Jose-Ramonda/PROYECTOFINAL_MASTER/Informe/main.tex

%\documentclass[12pt,a4paper]{article}
\documentclass[12pt,a4paper,twoside]{article}

% =======================
% Paquetes básicos
% =======================
\usepackage[spanish]{babel}    % Idioma español
\usepackage[utf8]{inputenc}    % Acentos en UTF-8
\usepackage[T1]{fontenc}       % Codificación de salida
\usepackage{lmodern}           % Fuente mejorada (Latin Modern)
\usepackage{graphicx}          % Insertar imágenes
\usepackage{amsmath, amssymb}  % Matemáticas
\usepackage{geometry}          % Márgenes
\usepackage{hyperref}          % Hipervínculos
\usepackage{enumitem}          % Listas personalizadas
\usepackage{caption}           % Mejoras en títulos de figuras/tablas
\usepackage{setspace}
\usepackage{float}   % Para usar [H] en tablas y figuras
\usepackage{csvsimple} %Para tablas
\usepackage{booktabs} % para tablas más limpias
\usepackage{graphicx}
\usepackage[style=american]{csquotes}

\usepackage{listings}
\usepackage{xcolor} % Para darle colores al código
\usepackage{bytefield}
\usepackage{graphicx} % Para rotar el texto si es necesario

\usepackage[nopatch=footnote]{microtype}%Corrige supuestamente los Overfull

%Veamos esto
\usepackage{tikz}
\usepackage{pgf-umlsd}

\lstset{
	language=C,
	basicstyle=\ttfamily\small,
	keywordstyle=\color{blue},
	commentstyle=\color{green!60!black},
	stringstyle=\color{orange},
	numbers=left,
	numberstyle=\tiny\color{gray},
	breaklines=true,
	frame=single,
}
% Configuración de márgenes
%\geometry{top=2.5cm, bottom=2.5cm, left=3cm, right=3cm}
\geometry{top=2.5cm, bottom=2.5cm, inner=3.5cm, outer=2.5cm}
% Para que LaTeX busque imágenes siempre en la carpeta img/
\graphicspath{{img/}}

% =======================
% Documento
% =======================
\begin{document}
	
	% Carátula
	\input{tex/00Caratula.tex}
	\clearpage
	\input{tex/01seccion1.tex}
	\thispagestyle{empty}%Oculta el indice
	\tableofcontents 
	\newpage

	% Secciones

	\input{tex/02seccion2.tex}
	\input{tex/03seccion3.tex}
	\input{tex/04seccion4.tex}
	\input{tex/05seccion5.tex}
	\input{tex/06seccion6.tex}
	\input{tex/07seccion7.tex}

\end{document}
