Jose-Ramonda/PROYECTOFINAL_MASTER/Informe/tex/00Caratula.tex

\begin{titlepage}
	\begin{center}
		\doublespacing
		\Large
		Universidad Nacional de Rosario \\
		Facultad de Ciencias Exactas, Ingeniería y Agrimensura
		
		\vspace{1cm}
		
		\textbf{\huge Proyecto Final de Carrera: \newline Trabajo final} \\[0.5cm]
		\textbf{\LARGE Control de Acceso para institución educativa} \\[0.5cm]
		\textbf{Año: 2026}
		
		\vfill
		
		% ===================
		% Datos del autor
		% ===================
		\large
		\textbf{Autor:} Ramonda, José \\
		\textbf{Legajo:} R-4423/7
		
		\vspace{1.5cm}
		
		% ===================
		% Director
		% ===================
		\large
		\textbf{Director:} \\

		 Prof. Ing. Daniel Marquez 

		\vfill
		
		\large
		Rosario, \today
		
	\end{center}
\end{titlepage}
