Jose-Ramonda/PROYECTOFINAL_MASTER/Informe/tex/06seccion6.tex

\section{Servidor}
El servidor constituye el núcleo del sistema. Consiste en una computadora con una distribución de Linux como sistema operativo, conectada por un lado al bus RS-485 mediante una interfaz serie y, por otro, tanto a la red de área local de la institución como a Internet.

La elección de Linux como entorno de ejecución otorga portabilidad al sistema, permitiendo su despliegue sobre diversas plataformas de hardware según la disponibilidad y los requerimientos de la instalación. Durante la etapa de desarrollo y pruebas, se utilizó una computadora portátil con Ubuntu junto a un convertidor USB a RS-485 estándar. Para la puesta en producción en campo, el cambio fundamental a nivel de hardware consiste en la incorporación de un convertidor de grado industrial con aislamiento galvánico (optoacoplado y con protecciones ante transitorios), lo cual previene bucles de masa (\textit{ground loops}) y garantiza la seguridad eléctrica tanto del equipo anfitrión como del bus de comunicaciones.

Cumplido este recaudo, el software puede desplegarse en cualquier servidor o PC convencional que ejecute Linux. Asimismo, una alternativa viable y compacta es el empleo de una computadora de placa reducida (\textit{Single Board Computer} o SBC), como una Raspberry Pi. Esta opción resulta especialmente conveniente cuando no se dispone de infraestructura de servidores previa o cuando se requiere ubicar la unidad de control en proximidad física al tendido del bus. Entre las ventajas añadidas del uso de una SBC destacan su bajo consumo energético y la posibilidad de prescindir de convertidores USB intermedios mediante el conexionado de un transceptor RS-485 directamente a los pines UART/GPIO del procesador.

La arquitectura consta de cuatro procesos

\begin{itemize}
    \item Un gestor de la interfaz serial que se encarga del polling y los comandos hacia los esclavos.
    \item La interfaz de usuario.
    \item El servidor HTTP.
    \item Un broker MQTT para comunicar los procesos entre sí.
\end{itemize}

La interfaz serial no solo gestiona la comunicación con los terminales, sino que también se ocupa del monitoreo de la conetividad de estos por ambas vías y resuelve internamente todo lo relacionado con los accesos mediante tags NFC.

El servidor HTTP se implementa sobre una instancia de node-red y también incorpora algunas funcionalidades auxiliares.

La interfaz de usuario está programada en python y utiliza la API de la aplicación de mensajería \enquote{Telegram}.

\subsection{Programa principal}
El dominio de la interfaz serial se ocupa de realizar las encuestas periódicas, verificar la conetividad y comandar a los esclavos, así como de procesar los datos recibidos por estos.

Está programado en python y se compone de varios módulos. Cada módulo incluye funciones que pueden ser llamadas desde otros archivos así como procesos que se disparan en hilos paralelos de ejecución (librería \textit{threading.py}). El programa principal \textit{main.py} crea los procesos y dispara los hilos.

En principio esta arquitectura presenta similitudes con la de los terminales implementados en FreeRTOS, pero existen diferencias clave que hay mencionar, la primera es que si bien los hilos se ejecutan mediante una estructura apropiativa gestionada por un scheduler que vive en el kernel del sistema operativo no existe en este caso tal cosa como asignación de prioridades, todos los hilos en estado ready comparten time slices del mismo tamaño.

Otro punto clave es el GIL de python o \enquote{Global Interpreter Lock}, Un semáforo de exclusión mutua (\textit{mutex}) diseñado para proteger las estructuras de memoria internas y el mecanismo de conteo de referencias frente a condiciones de carrera. Por esto, solo un hilo ejecuta código Python a la vez por proceso, impidiendo el paralelismo real en tareas de cálculo intensivo. Sin embargo, para operaciones de entrada/salida (como la comunicación serie o de red), el GIL se libera durante las esperas, permitiendo una concurrencia fluida y eficiente entre módulos.

A continuación se describen los distintos módulos que componen el sistema

\subsubsection{Módulo serie.py}
Este módulo es la interfaz serial del servidor e implementa la ejecución de un maestro del protocolo \enquote{Ramodbus}. El hilo principal de ejecución no requiere de una máquina de estados, sino que es secuencial. Intercambia información con los otros módulos mediante una cola de entrada y sendas colas de salida para cada nodo.

Las direcciones o identificadores de los nodos activos se definen en una tupla dentro del archivo de configuración. El hilo de comunicaciones itera cíclicamente sobre estos identificadores ejecutando la siguiente secuencia por cada nodo:

\begin{enumerate}
    \item Revisa el estado del nodo, si está marcado como desconectado, se omite su consulta para no penalizar el tiempo de ciclo.
    \item Comprueba si existen comandos pendientes en la cola asociada a dicho nodo.
    \item Si la cola contiene elementos, extrae el comando y lo transmite; en caso contrario, envía una trama periódica de consulta (\textit{polling}).
    \item Espera la respuesta del esclavo, luego de que responda o de un timeout pasa al siguiente nodo y repite.
\end{enumerate}

Si un nodo no responde, se incrementa un contador de fallos consecutivos que se reinicia ante cualquier recepción válida. Al superarse un umbral predefinido de reintentos fallidos, el nodo pasa al estado \textit{desconectado} y se emite una notificación al resto del sistema

Cuando se recibe una respuesta válida, si se trata de una simple confirmación (\texttt{ACK}) se descarta. Si en cambio contiene datos útiles, se encapsula en un diccionario con el formato \texttt{\{
                        \enquote{id\_nodo}: id\_nodo,
                        \enquote{cmd}: cmd\_recibido,
                        \enquote{payload}: payload\_recibido
                    \}}

La construcción de tramas se centraliza en una función encargada de estructurar el encabezado y computar el código de redundancia cíclica (CRC). Por su parte, la rutina de recepción bloqueante valida la dirección del destinatario, el encabezado y la coherencia del CRC, retornando la carga útil decodificada o el código de error correspondiente.

En el archivo de configuración se definen tres parámetros que afectan a la velociad de la comunicación.
\begin{itemize}
\item \textbf{Velocidad de transmisión (\textit{Baud rate}):} Tasa de transferencia en baudios del enlace físico.
\item \textbf{Tiempo de espera (\textit{Timeout}):} Tiempo límite que el maestro aguarda la respuesta del esclavo. Se establece con un margen superior al tiempo de respuesta nominal; por ello, la exclusión de nodos desconectados resulta indispensable para evitar retardos ociosos en el barrido.
\item \textbf{Intervalo entre consultas (\textit{Inter-polling delay}):} Pausa deliberada entre transacciones consecutivas para no saturar el medio y otorgar tiempo de procesamiento a los terminales.
\end{itemize}

\subsubsection{Módulo nexo.py}

Este módulo centraliza la lógica de control del servidor y la coordinación interna. Define la función pública \texttt{encolar()}, empleada tanto por rutinas internas como por otros módulos del proceso para ingresar comandos en las colas de salida sin interactuar directamente con el puerto serie.

Asimismo, ejecuta un hilo dedicado a procesar los elementos de la cola de entrada. Ante eventos de desconexión de terminales, publica una alerta en el tópico MQTT correspondiente; mientras que ante la recepción de tramas de datos, invoca a la rutina de análisis sintáctico (\textit{parser}) para despachar la ejecución hacia la subrutina correspondiente según el comando recibido.

\subsubsection{Módulo main\_mqtt.py}
Este módulo encapsula el cliente MQTT del proceso. Provee una función de publicación accesible por los demás módulos y ejecuta un hilo de escucha (\textit{listener}) que, mediante su propio analizador sintáctico, procesa los mensajes entrantes según el tópico y la carga útil (\textit{payload}) recibida

En general hay tres familias de tópicos anidadas en el tópico \enquote{sbc}.
El módulo nexo publica en el subtópico \enquote{sbc/notify} para disparar las alertas de desconexión o clonación de tags, y en \enquote{sbc/status/<nodo>} donde en <nodo> figura una string del número de nodo en formato hexadecimal. En estos tópicos se informan eventos en el payload, por ejemplo \enquote{OK\_PUERTA} es el aviso de que el comando de apertura impactó sobre el terminal y el acceso fue desbloqueado y \enquote{OK\_FOTO} informa que el terminal intentó (con o sin éxito) transmitir una imagen mediante HTTP.

La tercera rama corresponde a los tópicos de comandos bajo el formato \texttt{sbc/cmd/}, a los cuales el cliente permanece suscrito para recibir peticiones emitidas desde la interfaz de usuario. En este caso, la carga útil especifica el nodo destinatario; por ejemplo, si se recibe un mensaje en \texttt{sbc/cmd/abrir} con el valor \texttt{0x0A}, el módulo encola una orden de apertura dirigida al nodo 10, la cual se transmitirá físicamente durante su próxima consulta en el bus RS-485.
El payload de algunos mensajes de este tópico inclyen además del número de nodo la id del chat del usuario que los solicitó, el cual es utilizado en el proceso de node-red.

\subsubsection{Módulo red.py}
El múdulo de red realiza las funciones de conexión y mantenimiento de las conexiones a la red local de los terminales.
Incorpora el módulo subprocess, el cual permite inyectar comandos a la terminal del sistema operativo. Implementa funciones que mediante comandos de terminal obtienen la dirección ip del servidor, el nombre de la red wifi y la contraseña de acceso, para esta última es necesario tener privilegios de superusuario al ejecutar el script, esto no representa un problema en producción ya que al correr como servicios todos los procesos se ejecutan desde el usuario raiz.

Los datos obtenidos sirven como argumentos de otras dos funciones que transmiten las configuraciones de red a los nodos, una toma la ip y arma la trama de 6 bytes de ip + puerto para el servidor HTTP (por defecto se utiliza el puerto 1880) y la otra toma el nombre de la red y la contraseña, los segmentan en chunks de no más de 7 bytes y arman las tramas de formato subcomando + chunk actual + chunck totales + data, para indicar al terminal que modifique sus credenciales de acceso a la red.
Ambas funciones barren con la tupla de nodos y para cada uno encolan los mensajes que hagan falta para configurar la conexión.
Estas funciones se ejecutan al inicio del programa desde el main para que el sistema inicie con los nodos configurados.

También se incluyó un hilo de monitoreo, el cual periódicamente recorre un diccionario que asocia cada nodo con su ip reportada y verifica la conexión mediante un ping. Ante sucesivas fallas en el ping, se encola un comando de reconexión al terminal.

El diccionario es global y está definido en el archivo de configuración. Lo rellena el parser como respuesta a los comandos de WiFi provenientes del nodo, los cuales reportan la ip de este.

Esto se definió así dado que al ocupar una red ya existente, el sistema puede adaptarse a las asignaciones de ip dinámicas por DHCP del router.

\subsubsection{Módulo accesos.py}
Este módulo implementa toda la lógica de accesos mediante tags NFC. Gestiona la actualización del \enquote{padrón} de accesos, la validación de solicitudes y el registro histórico local.

Incorpora las librerías os para operar con archivos, csv para leer y escribir archivos de este formato y datetime para poder incorporar fecha y hora en los registros.

El padrón es un archivo csv que incluye los campos UID, contador, titular y habilitación.
la UID y el contador son los datos recibidos desde el terminal que deben validarse. El titular es el dueño del tag asociado y la habilitación es un campo booleano que permite desactivar tags ya sea manualmente  mediante la modificación del archivo o de forma automatica cuando se detecta una clonación.

Como la funcionalidad de acceso debe ser dinámica, no se puede consultar al archivo en cada solicitud, la función \texttt{cargar\_padron\_a\_ram()} rellena un diccionario con las UID, contadores y titulares de los tags habilitados. Esta función se llama al iniciar el proceso o mediante la llegada de un comando por MQTT desde la interfaz de usuario.

La trama de que envían los terminales consta de 7 bytes para el UID y 3 bytes para el contador.
El procesamiento de las tramas lo realiza el parser mediante funciones del módulo de acceso, priemro, con los datos recibidos llama a la función validar, la cual revisa primero que la UID coincida con alguna de las cargadas en ram y luego que el contador sea válido mediante los siguientes criterios:

\begin{itemize}
    \item El contador recibido no puede ser menor al guardado, ya que esto implicaría una clonación
    \item El contador recibido no puede ser mucho mayor al guardado, ya que esto implicaría que fue leído por fuera del sistema, se deja un margen para posibles fallas, por ejemplo una lectura válida con el servidor caído.
    \item Un caso excepcional es si el contador guardado tiene el valor -1, en este caso se toma cualquier valor como válidoya que se le asigna -1 a los tags nuevos a incorporar, o por si se quiere volver a incorporar un tag que fue desabilitado anteriormente, ya que pudo seguir siendo leído por los terminales y aumentando el contador de forma indefinida.
\end{itemize}

En el caso de que la solicitud sea válida, la función actualiza el contador tanto en ram como en el archivo y retorna éxito
Si la función retorna éxito, el parser encola un comando de apertura y posteriormente llama a la función registrar\_evento\_en\_log la cual registra en un csv la entrada válida.
En el caso de que la UID no se encuentre en el padrón, la función de validación devuelve \enquote{\texttt{DESCONOCIDO}} y el parser registra el evento.

Si el fallo en la validación está en el contador, la función de validación dehabilita el tag tanto en ram como en el padrón y devuelve \enquote{\texttt{CLONACIÓN}}. El parser además de registrar el evento, dispara una alarma por MQTT para que la interfaz notifique los usuarios.

\subsection{Instacia de node-red}

Node-red es una herramienta de automatización de flujos de datos. Al ejecutarse levanta un servidor accesible desde el navegador que permite editar los llamados \enquote{flujos} mediante una interfaz gráfica en la cual uno arrastra \enquote{nodos} y los une de forma similar a un diagrama de bloques. Exiten bloques para manejos de distintos protocolos asi como bloques de función programables en javascript.

La principal ventaja de su uso es la simpleza y rapidez de implementación, además de que para flujos de datos simples permite mantener un orden visual muy claro. Node-red deja de ser conveniente cuando la aplicación sube en complejidad o cuando la lógica comienza a considerar demasiados escenarios, por lo que en esta aplicación se mantuvo para aplicar los flujos de datos más simples.

El principal uso que se le da en el sistema es el de servidor HTTP. Mediante un bloque \enquote{POST} recibe las imágenes transmitidas por los terminales y las guarda en un directorio específico mediante un nodo de archivo.

Este flujo también incorpora un cliente MQTT que suscribe al tópico de comandos, el cual guarda en memoria el nodo y la id del chat del usuario que lo disparó.
También suscribe al tópico de status, para retransmitir la información al tópico notify.
Esto lo hace para el caso de los comandos de apertura, para enviar la confirmación solo al usuario que la solicitó. En el caso de las fotografías, revisa si fue solicitada por un usuario y lo utiliza como destino, si la fotografía se corresponde a alguien solicitando el acceso desde fuera, indica que se transmita a todos los usuarios.
El payload de la foto es un json que indica el evento (si la foto fue solicitada por un usario o \enquote{espontánea}, es decir por solicitud de acceso de un visitante), el destinatario y la ruta absoluta de la fotografía.

Otro flujo simple que se implementó es la carga histórica del registro de accesos. Mediante un nodo de inyección programado para dispararse diariamente a cierta hora, se envía un email con el archivo csv de registros que contiene los correspondientes a ese día.
El flujo utiliza un nodo de archivo para saber donde \enquote{buscar} el registro, luego un nodo de función para formatear el mensaje y finalmente un nodo e-mail, el cual está configurado con la dirección de destinatario así como con una clave de aplicación, en este caso de gogle para trabajar con gmail.

El nodo \enquote{complete} se asocia a otros nodos y se dispara cada vez que el objetivo realiza su función, al apuntarlo al nodo de e-mail, sabe cuando el correo se envió exitosamente y comannda un nodo de archivo para que elimine el registro viejo, así cada archivo solo representa al día pasado. En el caso de error, por ejemplo que a la hora de enviar el correo el servidor pierda la conexión a internet, no se borra el archivo y sigue acumulando registros hasta que se envíe.

Hay un tercer flujo desactivado que permite inyectar tramas por el bus RS-485. Utiiza nodos de inyección manual conectados a un nodo de función que calcula y añade el CRC y envía la trama a un nodo serial. También incluye un nodo serial de entrada conectado a un nodo de debug para observar las respuestas. Este flujo se utilizó en el desarrollo para porbar el protocolo y se mantuvo para pruebas. Si bien se tuvo que desactivar para no generar conflictos con el uso del puerto serie del servidor, que ahora utiliza el programa principal, se mantiene como una herramienta de debug y pruebas de actualizaciones en el futuro.

\subsection{Interfaz de Usuario}

La interacción principal con el sistema de control de acceso se centraliza a través de un \textit{bot} en la aplicación de mensajería instantánea Telegram. Esta plataforma fue seleccionada frente a alternativas populares como WhatsApp debido a que ofrece una API gratuita, abierta, ampliamente documentada y accesible. En contraste, la API de WhatsApp requiere un registro empresarial, es de pago y presenta un entorno más cerrado. Adicionalmente, esta decisión responde al requerimiento explícito del cliente de mantener las funcionalidades de control de acceso separadas de sus comunicaciones cotidianas, evitando que los comandos y notificaciones de seguridad se pierdan entre otras conversaciones.

El \textit{bot} permite automatizar respuestas en formato de chat e implementar comandos e interfaces gráficas basadas en menús. La aplicación fue desarrollada en Python y se ejecuta como un proceso completamente independiente. Esta decisión arquitectónica permite desacoplar la interfaz del resto de las tareas del sistema, aislando posibles puntos de fallo. 

Asimismo, la biblioteca \texttt{python-telegram-bot} requiere el uso nativo del módulo \texttt{asyncio} para el manejo de tareas asíncronas. Dado que este módulo implementa un esquema de concurrencia colaborativa, su convivencia con el módulo \texttt{threading} tradicional dentro del mismo proceso resulta compleja y propensa a colisiones, lo que refuerza la necesidad técnica de aislar el \textit{bot} en su propio espacio de ejecución.

\subsubsection{Arquitectura y Máquina de Estados}
El núcleo de la interfaz se basa en una Máquina de Estados Finitos (MEF) implementada mediante un \texttt{ConversationHandler}. Este diseño previene comportamientos erráticos al restringir las acciones del usuario según su estado actual en el sistema. Los estados definidos son:
\begin{itemize}
    \item \textbf{ESPERANDO\_USER y ESPERANDO\_CLAVE:} Flujo inicial de autenticación.
    \item \textbf{EN\_MENU\_USUARIO:} Estado de reposo donde el sistema aguarda interacciones a través de los teclados en línea (botones).
    \item \textbf{ESPERANDO\_CLAVE\_ADMIN:} Estado transitorio para la elevación de privilegios.
\end{itemize}
Cualquier entrada de texto no reconocida mientras el sistema se encuentra en estado de menú es capturada e ignorada de forma segura para no romper el flujo de la conversación.

\subsubsection{Módulo de Autenticación y Roles}
La seguridad de la interfaz se gestiona de forma local a través del archivo \texttt{credenciales.json}. El sistema clasifica a los individuos en tres categorías: \textit{Invitados} (sin acceso), \textit{Usuarios Estándar} (pueden operar puertas y cámaras) y \textit{Administradores} (pueden auditar el sistema y gestionar el hardware). 

Al ingresar exitosamente, el sistema vincula de forma permanente el \texttt{chat\_id} numérico de Telegram con el perfil del usuario. Esto es fundamental para el posterior enrutamiento de notificaciones asíncronas y alertas de seguridad específicas a cada individuo.

\subsubsection{Navegación y Menús Interactivos}
Para minimizar los errores de tipeo, la operación se realiza íntegramente mediante teclados en línea (\texttt{InlineKeyboardMarkup}). Los menús son dinámicos; por ejemplo, la selección de hardware lee directamente las direcciones físicas reales del bus de los nodos (como \texttt{0x0A} para el Acceso Frente) desde la configuración (\texttt{botconfig.py}) y las embebe en la carga útil (callback) de cada botón. 

El Administrador cuenta con un panel avanzado que le permite:
\begin{itemize}
    \item Listar el estado y privilegios de todos los usuarios registrados.
    \item Activar o detener el \textit{Modo Programación} directamente en el hardware de los nodos remotos.
    \item Descargar y actualizar la base de datos física de accesos.
\end{itemize}

\subsubsection{Integración MQTT y Notificaciones Asíncronas}
El módulo \texttt{MQTT.py} gestiona dos vías de comunicación simultáneas para comunicar este proceso con el resto del sistema:
\begin{enumerate}
    \item \textbf{Emisión de comandos (\texttt{sbc/cmd/}):} Ejecuciones síncronas gatilladas por los botones del bot (aperturas, toma de fotografías, inicio de modo programación).
    \item \textbf{Escucha de notificaciones (\texttt{sbc/notify}):} Un hilo secundario que se mantiene suscrito al bróker para atajar alertas provenientes de Node-RED o del hardware.
\end{enumerate}

Este hilo secundario cuenta con un bucle de eventos propio (\texttt{asyncio}) que le permite despachar contenido multimedia a los usuarios sin bloquear la ejecución principal de la interfaz. Esto incluye capturas fotográficas de control, alertas tempranas por pulsación de timbres físicos y notificaciones críticas de seguridad (por ejemplo, el bloqueo automático ante el escaneo de una tarjeta clonada).

\subsubsection{Gestión Dinámica del Padrón de Accesos}
El sistema resuelve la actualización de credenciales NFC de forma intuitiva. El administrador puede solicitar la descarga del archivo \texttt{accesos\_autorizados.csv} directamente desde el chat. Una vez editado externamente, la actualización en el servidor SBC se logra adjuntando el nuevo documento a la conversación. El bot ataja el archivo entrante, valida su nomenclatura, lo descarga reemplazando el padrón anterior en el disco y publica un comando MQTT (\texttt{actualiza}) para que el hardware refresque sus listas locales de permisos.
