Jose-Ramonda/PROYECTOFINAL_MASTER/Informe/tex/04seccion4.tex

\section{Alcance del proyecto}
Se propone en el marco de este proyecto desarrollar un prototipo funcional que pueda ser adaptado a un entorno real como el de la problemática, incluyendo:

\begin{itemize}
	\item Construcción y programación de al menos un terminal incluyendo el microcontrolador, la cámara, el módulo RFID y las comunicaciónes contra el servidor.
	\item Programación del servidor incluyendo administración de comunicación multipunto, procesamiento de datos de entrada, historización de datos relevantes y programación de la comunicación con dispositivos externos.
	\item Comunicaciones de los dispositivos
	\item Escritura de tags para pruebas
\end{itemize}

Quedarán como mejoras a futuro el agregado de acceso remoto de mantenimiento fuera de red para el servidor, la migración de funcionalidades en medida de lo posible a lenguajes de más bajo nivel para reducir el costo computacional y poder utilizar hardware mínimo y más económico, uso de algoritmos más sofisticados para reforzar la seguridad y la creación de perfiles alternativos de autorización  de acceso para extender el sistema a alumnos que entren fuera de horario en visión de escalar a una escuela inteligente.
