Jose-Ramonda/PROYECTOFINAL_MASTER/SASE/SASE.odt

Control de acceso para institución educativa

Autor: José Ramonda

Director: Daniel Marquez

Resumen:

Este trabajo presenta el diseño e implementación de un prototipo de sistema de control de acceso distribuido para una institución de educación secundaria. La arquitectura propuesta se compone de terminales inteligentes ubicados en los puntos de ingreso y un servidor central de gestión. Los terminales emplean el microcontrolador ESP32 como unidad principal de control, el cual se comunica con el servidor mediante un enlace serial RS-485 impulsado por un protocolo a nivel de aplicación propietario inspirado en Modbus RTU. Como periféricos principales, integran un lector NFC basado en el chip PN532 para la validación de credenciales y un kit de desarrollo ESP32-CAM encargado de la captura y transmisión de fotografías a través de la red Wi-Fi de la institución. Asimismo, gestionan dos relés para accionar el destrabador de puerta y la sirena sonora, preservando la infraestructura previa del establecimiento.

El firmware de los microcontroladores fue desarrollado en C sobre el framework oficial ESP-IDF, implementando una arquitectura modular multitarea basada en el sistema operativo en tiempo real FreeRTOS.

El sistema contempla dos modalidades de validación: por un lado, la lectura de tags NFC cuyos datos son autenticados contra el servidor central; por otro, una validación visual de una fotografía de un visitante que solicita acceso por parte de un usuario humano. En este flujo el visitante es fotografiado por la ESP32 CAM, la cual transmite la captura al servidor mediante HTTP, y este se lo retransmite al validador mediante la interfaz de usuario, en este caso, un bot de la aplicación Telegram.

En el nodo central, el servidor opera sobre un sistema operativo Linux y se compone de tres procesos desacoplados: un motor principal de control en Python para la gestión de comunicaciones seriales, un proceso independiente en Python para el bot de Telegram y un servidor HTTP en Node-RED que recibe el flujo de imágenes. La interconexión entre procesos se resuelve mediante subscripciones a distintos tópicos MQTT relacionados a los diferentes tipos de eventos. Se ejecuta un broker local Mosquitto, y los clientes en Python utilizan la librería Paho.

Como resultado, se obtuvo un prototipo funcional, modular y de bajo costo que resuelve la automatización del acceso de forma segura. Se concluye que la combinación de comunicaciones robustas por cable (RS-485) con flujos inalámbricos livianos y de baja responsabilidad resulta eficaz para entornos escolares, ofreciendo una solución escalable apta para ser migrada a una Single Board Computer como una Raspberry Pi.

Introducción

La Escuela de Educación Secundaria Orientada (E.E.S.O.) N° 214 "Mariano Moreno" (Santa Isabel, Santa Fe) requirió el desarrollo de un sistema de gestión y control de acceso para sus instalaciones. La institución cuenta con tres puntos de ingreso distribuidos a lo largo de una manzana completa, estando el punto más alejado a 40 metros de las oficinas administrativas. La problemática principal reside en la imposibilidad de destinar personal exclusivo para la atención y apertura presencial de puertas fuera del horario masivo de entrada, así como para la recepción de visitantes externos (como tutores legales). Además, debido a que el personal no docente realiza tareas de mantenimiento en diversos sectores del establecimiento, con frecuencia se encuentra fuera del alcance auditivo del timbre tradicional, lo que genera demoras y fallos en la detección de ingresos.

Se definieron los siguientes requerimientos para el proyecto:

- Autonomía y registro: Permitir el ingreso automatizado del personal de la institución (docente y no docente), generando registros de los eventos.
- Gestión remota e identificación: Ofrecer un mecanismo para que el personal autorizado pueda validar la identidad de un visitante externo mediante una captura fotográfica y habilitar el acceso de forma remota desde un dispositivo móvil.
- Integración y alcance: Mantener las funcionalidades elementales previas (como la apertura local y la señal sonora) y cubrir distancias físicas de hasta 40 metros entre los accesos y la gestión central.
- Escalabilidad: Sentar las bases para la posterior incorporación del control de puntualidad del alumnado.

Como solución a esta necesidad, se diseñó e implementó un prototipo cliente-servidor compuesto por terminales inteligentes ubicados en cada punto de acceso y un nodo central de gestión. Los terminales se encargan de la lectura de credenciales, la captura fotográfica de visitantes y el accionamiento de los dispositivos de apertura, mientras que el servidor central procesa las validaciones y orquesta la comunicación con los usuarios responsables a través de una interfaz de mensajería remota.

Objetivos:

El alcance de este trabajo comprende la construcción y validación de un prototipo funcional de "Producto Mínimo Viable" (MVP) que responda a los requerimientos operativos de la institución.

Objetivo General

Diseñar, implementar y evaluar un sistema de control de acceso distribuido basado en una arquitectura cliente-servidor, que automatice la validación de credenciales del personal y gestione la autorización remota e identificación visual de visitantes.

Objetivos Específicos:

- Desarrollar al menos un terminal de acceso inteligente: Diseñar y programar el nodo periférico para la adquisición de datos de credenciales, la captura de imágenes de visitantes y el control de los actuadores locales (destrabador y señal sonora).
- Implementar el servidor central de gestión: Desarrollar el entorno de procesamiento central responsable de la administración de la comunicación multipunto, la validación de accesos, la persistencia histórica de eventos y la orquestación de la interfaz de usuario remota.
- Asegurar la robustez de las comunicaciones: Garantizar la transmisión confiable de datos de control e imágenes a través de los enlaces cableados e inalámbricos entre los terminales y el nodo central, superando la distancia de 40 metros requerida.
- Validar el prototipo de forma integrada: Realizar pruebas de banco para verificar la correcta interacción entre los componentes del sistema, la respuesta en tiempo real y el cumplimiento de las tareas operativas esenciales.

Antecedentes:

En el mercado actual existen diversas soluciones comerciales de control de acceso, siendo las denominadas "cerraduras inteligentes" las que mas se adaptan a las necesidades de este proyecto. Estos dispositivos integran funcionalidades como la apertura mediante credenciales físicas o electrónicas, captura de imágenes, validación biométrica y gestión remota desde aplicaciones móviles.

Sin embargo, estas soluciones presentan dos limitaciones fundamentales para el escenario de aplicación considerado:

- Escalabilidad y costo: Cada cerradura opera como un nodo autónomo e independiente con electrónica de mayor costo individual. En instalaciones con múltiples puntos de acceso, el costo escala de forma lineal. En contraste, una arquitectura centralizada distribuye los costos al concentrar la inteligencia y la gestión en un servidor único, manteniendo terminales de acceso económicos y logrando un costo marginal por puerta sensiblemente menor.
- Integración y escalabilidad: Las soluciones comerciales constituyen sistemas cerrados con finalidades y capacidades rígidas. La propuesta de este trabajo, en cambio, ofrece la infraestructura para un sistema IoT multifunción orientado al control de acceso, pero personalizable y escalable como un primer paso hacia una escuela inteligente.

Desarrollo:

El sistema se desarrolla sobre una arquitectura centralizada alrededor del servidor, el cual se comunica y comanda los llamados “terminales” en los distintos puntos de acceso.

Para garantizar la integridad del canal crítico de control a lo largo de los 40 metros de recorrido, se optó por un bus serial cableado bajo el estándar industrial RS-485. Por el contrario, la transmisión de archivos multimedia se derivó a una red Wi-Fi local para no saturar el ancho de banda del bus serial. En los terminales, el procesamiento de credenciales se resolvió mediante el chip PN532 sobre el bus SPI debido a la flexibilidad del protocolo NFC (13.56 MHz, ISO/IEC 14443A) frente a lectores RFID convencionales. La captura de imágenes se asignó al módulo ESP32-CAM, aprovechando su memoria PSRAM para gestionar el almacenamiento temporal de las imágenes y enviarlos vía peticiones HTTP POST hacia el servidor.

El firmware fue desarrollado en C sobre el framework oficial ESP-IDF, implementando el sistema operativo en tiempo real FreeRTOS. La lógica de control se estructuró en tareas independientes desacopladas comunicadas y sincronizadas por diferentes métodos.

Para la línea de comunicación directa entre el servidor y los terminales, se optó por el protocolo de comunicación serial RS-485, el cual garantiza robustez y tiempos de respuesta suficientemente bajos para los requerimientos del sistema. En la capa de aplicación se desarrolló el protocolo “Ramodbus” inspirado en Modbus RTU ya que este está orientado a comunicaciones maestro – esclavo con múltiples esclavos. Se mantiene el sistema de arbitraje por polling del maestro, así como la detección de errores mediante un CRC de 16 bits. Uno de los principales cambios es la delimitación de tramas, se optó por simpleza en la implementación de no utilizar silencios para delimitar inicios de trama, si no que utilizar un byte de start, ademas se agregó al encabezado un campo de longitud de payload para que el receptor sepa cuantos bytes va a recibir. Esto permite a los esclavos responder y al maestro seguir con el ciclo de encuestas apenas terminen de recibir el mensaje sin necesidad de esperar un timeout cada vez. Se mantienen en el encabezado el campo de dirección del destinatario y de número de comando.

El otro cambio importante son los comandos, los cuales se dividen en comandos obligatorios (como el de polling / ACK de los mensajes) y comandos de la aplicación que son asignados por el desarrollador.

Los comandos también se dividen en comandos de control, los cuales no tienen payload y comandos de flujo, los cuales incluyen información adicional aparte del número de comando. Se definió que los comandos entre 0 y 99 sean de control y entre 100 y 255 de flujo.

La comunicación serial del esclavo consta de dos módulos, uno es el módulo de interfaz UART compuesto por una tarea que recibe los datos y los retransmite a la tarea receptora del protocolo, y una función que transmite mensajes.

El otro es la librería del protocolo que consta principalmente de dos tareas, el parser, que recibe los datos crudos de la tarea UART, agrupa los mensajes completos, valida el CRC, retransmite los mensajes a las tareas correspondientes y notifica a la segunda tarea del protocolo, el dispatcher, el cual apenas es notificado de que un mensaje fue recibido correctamente, busca en una cola de recepción si hay información nueva para transmitir y, en caso de no haberla transmite un ACK. Esto permite que la respuesta del esclavo sea inmediata, lo que puede llegar a compensar la demora de haber agregado un byte de start y el campo de longitud. Una consecuencia de esto es que si el maestro solicita datos, el esclavo responderá con un ACK y los datos los devolverá en un ciclo de polling posterior.

Para la validación por credenciales se optó por utilizar módulos de tecnología NFC, en este caso uno basado en el chip PN532 conectado mediante SPI. Como credenciales se utilizan los tags NFC NTAG213/215/126 los cuales, ademas de permitir identificarse mediante su identificador único (UID) incorporan otras funcionalidades aprovechables en materia de seguridad.

Los NTAG tiene varios registros donde se puede almacenar información, ademas de varios de configuraciones, entre ellas se puede proteger la lectoescritura de los registros con una contraseña configurable, así como se le configura un password-ack (PACK) que es una contraseña secreta de respuesta con el que el tag se identifica como auténtico. Otra cosa que incorporan los tags es un contador de lecturas por hardware, así como una función de espejado del contador en un registro configurable.

La tarea NFC reacciona al evento de detección de un tag en la cercanía del sensor, este lee la UID del tag y con ella mediante un hash calcula su contraseña y su PACK. Envía la contraseña y lee el PACK para validarlo, entonces lee el registro donde se refleja el contador y agrega a la cola de salida una trama con un comando correspondiente y un payload compuesto por el UID y el contador ( 7 + 3 bytes respectivamente) para que el servidor valide con estos datos si comandar o no una apertura mediante el accionamiento de un relé que comanda el destrabador eléctrico.

La ESP32 CAM también se programó en C mediante ESP IDF, con una arquitectura similar de tareas en FreeRTOS. Se comunica con el controlador principal mediante UART y cuenta con dos módulos principales, uno que mantiene la conectividad WiFi, el cual puede comandarse (desde el servidor y a través del controlador principal) para guardar/cambiar las credenciales de acceso a la red, conectarse a la red y desconectarse. El SSID y la contraseña de la red se guardan en memoria flash no volatil para poder reconectarse ante reinicios del sistema.

El módulo de la cámara, este se nutre de la librería oficial del fabricante se basa en una tarea, la cual ante la solicitud del controlador principal (ya sea por orden previa del servidor o como respuesta a la interrupción del pulsador con el cual los visitantes solicitan acceso), la cámara captura una imagen e intenta enviarla mediante HTTP tres veces, luego, independientemente del resultado, confirma el intento. Es responsabilidad del servidor luego verificar si la fotografía llegó correctamente.

La URL del servidor HTTP también se transmite desde el servidor y se almacena en memoria no volátil

Se implementó sobre Ubuntu Linux para facilitar la posterior migración a ordenadores monoplaca (Single Board Computers - SBC) como una Raspberry Pi 3B+ bajo Raspberry Pi OS. Esta arquitectura minimiza el costo y consumo energético, permitiendo conectar el transector RS-485 directamente a los pines GPIO del procesador, lo que brinda una interfaz serial de mayor estabilidad y robustez respecto a los adaptadores comerciales USB.

El software se modularizó en tres procesos independientes desacoplados mediante el protocolo MQTT sobre un broker local Mosquitto. Un motor de control en Python administra la comunicación serial RS-485 y la validación de credenciales con la base de datos; un servidor en Node-RED expone el endpoint HTTP que recibe y almacena las imágenes; y un proceso independiente en Python gestiona un bot de Telegram como interfaz de usuario. Cuando un visitante solicita acceso, el servidor orquesta la entrega de la fotografía al bot, permitiendo la supervisión visual y la autorización remota por parte del personal.

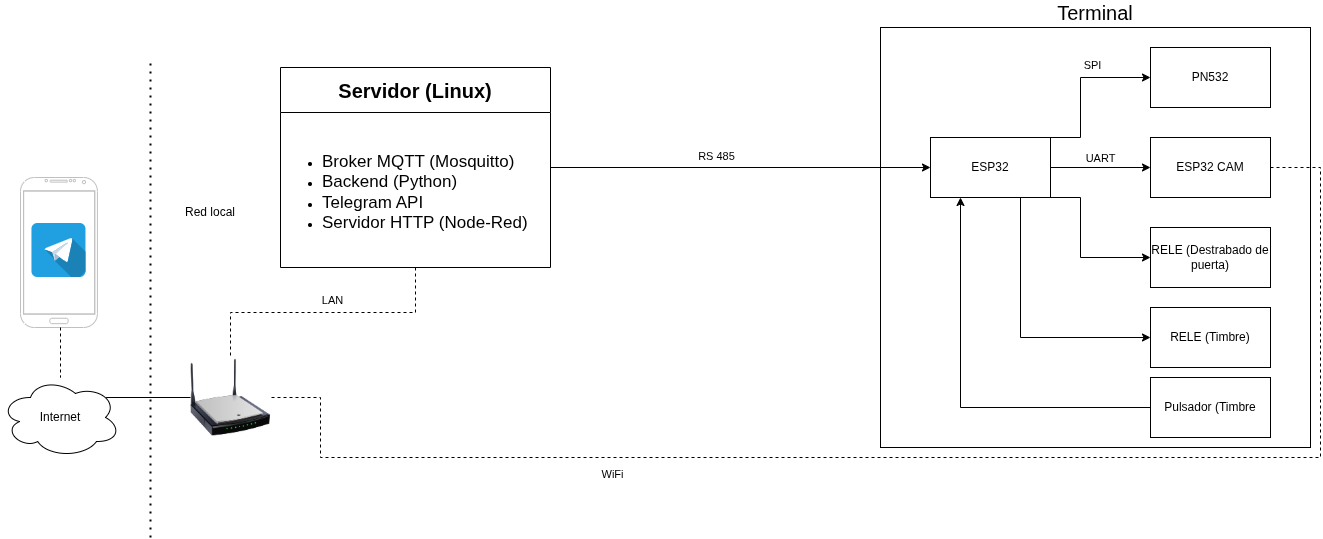
[picture p6: figure]

Experimentación y medición:

Se realizaron durante e desarrollo pruebas de las distintas funcionalidades por separado, llegando a construirse un terminal funcional que permite fundamentalmente la aplicación del protocolo serial, este fue probado mediante la inyección de comandos desde node-red para emular el comportamiento del maestro manualmente. Mediante este método se depuró y verificó el funcionamiento de la activación de los relés, los avisos de eventos, el empaquetado válido de las lecturas del módulo NFC, la gestión de la conexión a la red junto con la retención de credenciales en memoria no volátil y la captura de fotografías con su posterior transmisión al servidor HTTP.

En el nodo central se corroboró el desacoplamiento e interconexión de los tres procesos principales (backend de control, interfaz de Telegram y servidor HTTP). La validación del flujo de eventos y estados se realizó inyectando mensajes en los tópicos del broker MQTT a través de una herramienta cliente por línea de comandos en Linux. Con este esquema se verificó el correcto flujo de autenticación, la navegación por los menús del bot de Telegram y la emisión de comandos remotos.

Conclusiones y Trabajos Futuros:

Cumplimiento de los objetivos:

El proyecto se encuentra en la etapa final de integración del sistema. Si bien el alcance práctico se redefinió respecto a la propuesta inicial hacia la consolidación de un prototipo funcional de laboratorio centrado en las funcionalidades estructurales básicas, se lograron validar de forma independiente los pilares del diseño: la robustez del enlace de comunicación serial, la modularidad del firmware en FreeRTOS y el desacoplamiento de servicios en el servidor mediante MQTT

Limitaciones:

- Integración global del sistema: No se ha completado la ejecución conjunta e integrada de la totalidad de los módulos en un ciclo único punta a punta, utilizando de forma intermedia la emulación por inyección de tramas para la evaluación de respuestas.
- Fallas de hardware: No se solucionaron los problemas que impiden del funcionamiento del PN532 conectado a la PCB.

Mejoras a futuro:

Como acciones inmediatas para la finalización de esta etapa se contempla la depuración física de la interfaz del lector NFC y la integración definitiva de los procesos en el backend para la operación continua del sistema.

Posteriormente, como líneas de desarrollo futuro para la evolución hacia un Producto Mínimo Viable (MVP) desplegable en campo, se proponen la migración del servidor a una computadora monoplaca (SBC), el desarrollo de alarmas de fallas físicas ante falta de respuesta de alguno de los nodos en el bus RS-485, la automatización de la gestion de la conectividad inalámbrica a la red y la funcionalidad de administración de usuarios desde la interfaz.

[1] Espressif Systems, ESP32 ESP-IDF Programming Guide (Release v5.3), Espressif Systems, 2024.

[2] Amazon Web Services, The FreeRTOS™ Reference Manual: API Functions and Configuration Options, Amazon Web Services, 2023.

[3] R. Barry y The FreeRTOS Team, Mastering the FreeRTOS™ Real Time Kernel: A Hands-On Tutorial Guide, Rel. v1.1.0, Amazon Web Services, 2023.

[4] NXP Semiconductors, NTAG213/215/216: NFC Forum Type 2 Tag compliant IC with 144/504/888 bytes user memory, Data Sheet, Rev. 3.0, NXP Semiconductors, 2013.
