Jose-Ramonda/PROYECTOFINAL_MASTER/Informe/img/DB.jpg

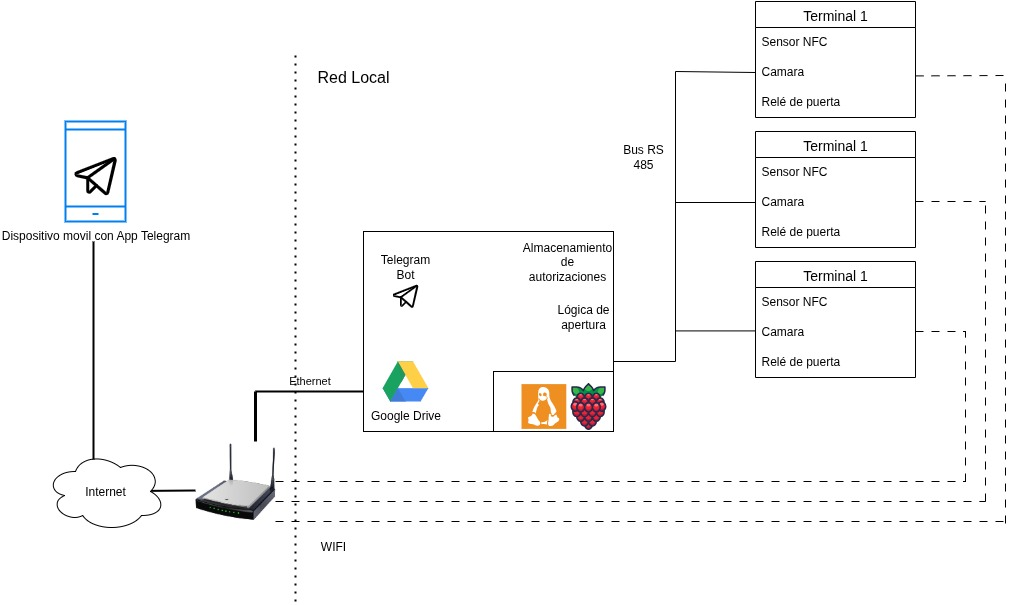
Informe/img/DB.jpg
