Jose-Ramonda/PROYECTOFINAL_MASTER/Informe/img/Plano.png

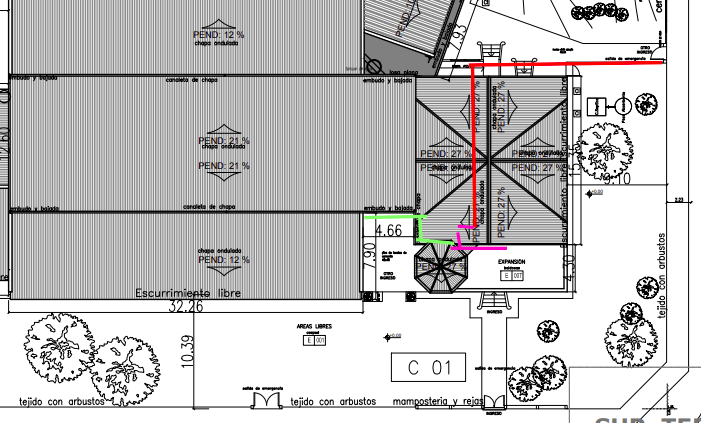
Informe/img/Plano.png
