Jose-Ramonda/PROYECTOFINAL_MASTER/SBC/fotos/captura_actual.jpeg

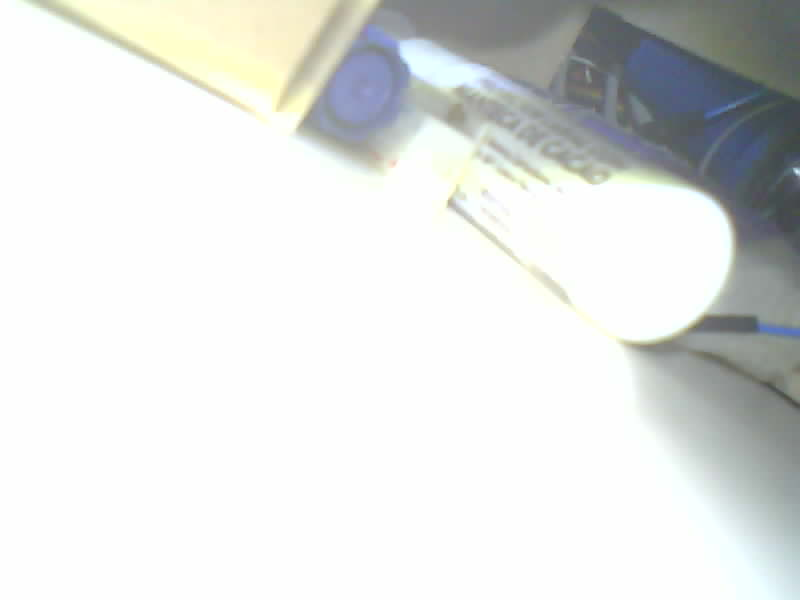
SBC/fotos/captura_actual.jpeg
