Jose-Ramonda/PROYECTOFINAL_MASTER/PCB/PCB.kicad_pcb

## KiCad design PCB/PCB.kicad_pcb (2026-08-20)

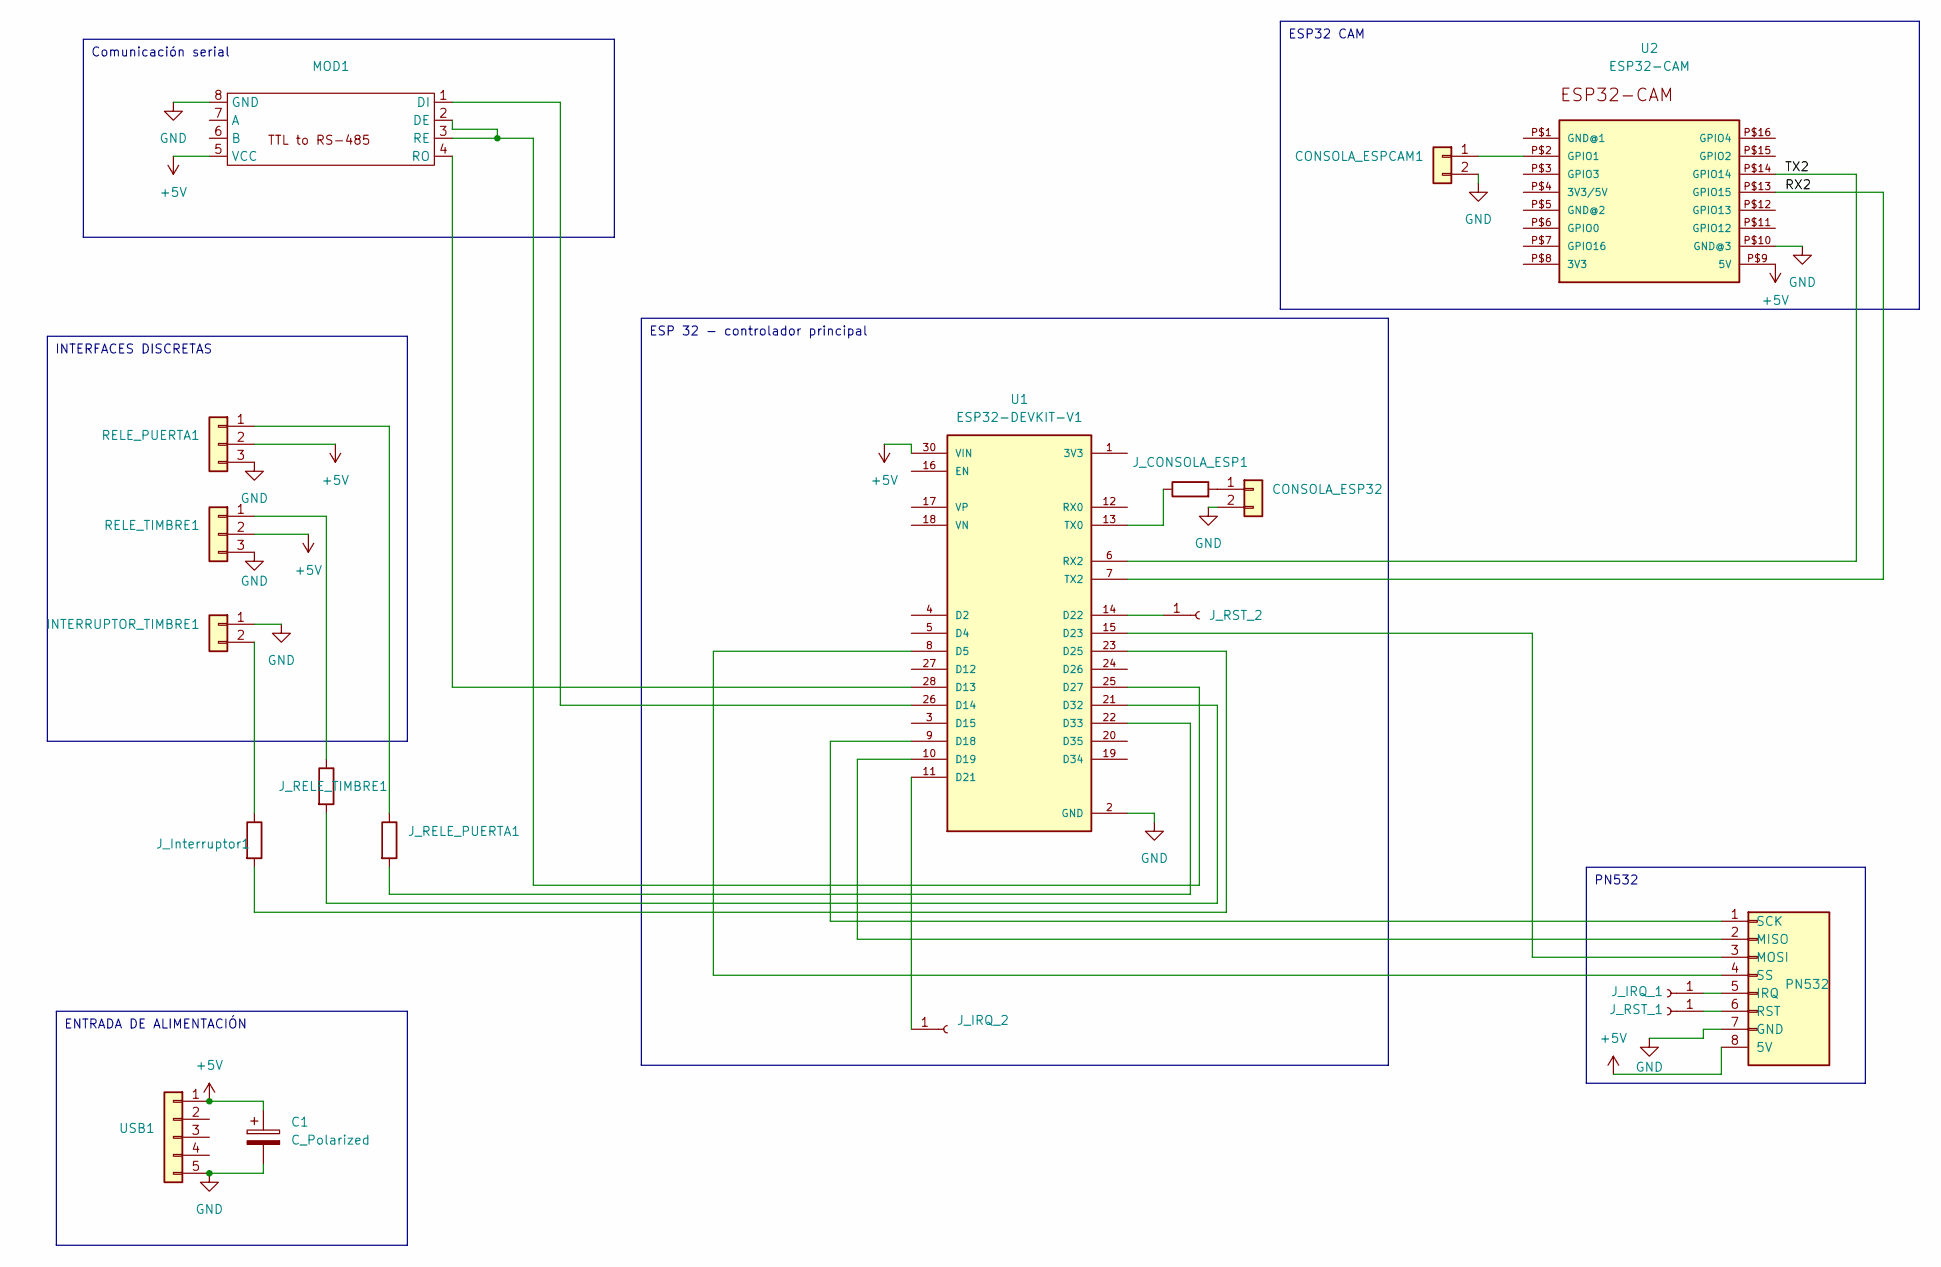
[picture p10: schematic PCB.kicad_sch]

Parts:
C1: C_Polarized; CP_Radial_D10.0mm_P2.50mm
CONSOLA_ESP32: Conn_01x02; PinHeader_1x02_P2.54mm_Vertical
CONSOLA_ESPCAM1: Conn_01x02; PinHeader_1x02_P2.54mm_Vertical
INTERRUPTOR_TIMBRE1: Conn_01x02; TerminalBlock_Phoenix_MKDS-1,5-2_1x02_P5.00mm_Horizontal
J_CONSOLA_ESP1: 0; R_Axial_DIN0207_L6.3mm_D2.5mm_P5.08mm_Vertical
J_IRQ_1, J_IRQ_2: Conn_01x01_Socket; PinSocket_1x01_P2.54mm_Vertical
J_Interruptor1: 0; R_Axial_DIN0207_L6.3mm_D2.5mm_P5.08mm_Vertical
J_RELE_PUERTA1: 0; R_Axial_DIN0207_L6.3mm_D2.5mm_P5.08mm_Vertical
J_RELE_TIMBRE1: 0; R_Axial_DIN0207_L6.3mm_D2.5mm_P5.08mm_Vertical
J_RST_1, J_RST_2: Conn_01x01_Socket; PinSocket_1x01_P2.54mm_Vertical
MOD1: MAX485
PN532: PN532-Adafruit; PinHeader_1x08_P2.54mm_Vertical
RELE_PUERTA1: Conn_01x03; PinSocket_1x03_P2.54mm_Vertical
RELE_TIMBRE1: Conn_01x03; PinSocket_1x03_P2.54mm_Vertical
U1: ESP32-DEVKIT-V1; MODULE_ESP32_DEVKIT_V1; PARTREV N/A
U2: ESP32-CAM
USB1: Conn_01x05; PinSocket_1x05_P2.54mm_Vertical

Connections:
+5V: C1.1, MOD1.5 (VCC), PN532.8 (5V), RELE_PUERTA1.2, RELE_TIMBRE1.2, U1.30 (VIN), U2.P$9 (5V), USB1.1
/RX2: U1.7 (TX2), U2.P$13 (GPIO15)
/TX2: U1.6 (RX2), U2.P$14 (GPIO14)
GND: C1.2, CONSOLA_ESP32.2, CONSOLA_ESPCAM1.2, INTERRUPTOR_TIMBRE1.1, MOD1.8 (GND), PN532.7 (GND), RELE_PUERTA1.3, RELE_TIMBRE1.3, U1.2 (GND), U1.29 (GND), U2.P$10 (GND@3), USB1.5
unnamed: CONSOLA_ESP32.1, J_CONSOLA_ESP1.2
unnamed: CONSOLA_ESPCAM1.1, U2.P$2 (GPIO1)
unnamed: INTERRUPTOR_TIMBRE1.2, J_Interruptor1.1
unnamed: J_IRQ_1.1, PN532.5 (IRQ)
unnamed: J_IRQ_2.1, U1.11 (D21)
unnamed: J_RST_1.1, PN532.6 (RST)
unnamed: J_RST_2.1, U1.14 (D22)
unnamed: MOD1.2 (DE), MOD1.3 (RE), U1.25 (D27)
unnamed: MOD1.1 (DI), U1.26 (D14)
unnamed: MOD1.4 (RO), U1.28 (D13)
unnamed: PN532.2 (MISO), U1.10 (D19)
unnamed: PN532.3 (MOSI), U1.15 (D23)
unnamed: PN532.1 (SCK), U1.9 (D18)
unnamed: PN532.4 (SS), U1.8 (D5)
unnamed: J_RELE_PUERTA1.1, RELE_PUERTA1.1
unnamed: J_RELE_TIMBRE1.1, RELE_TIMBRE1.1
unnamed: J_Interruptor1.2, U1.23 (D25)
unnamed: J_RELE_TIMBRE1.2, U1.21 (D32)
unnamed: J_RELE_PUERTA1.2, U1.22 (D33)
unnamed: J_CONSOLA_ESP1.1, U1.13 (TX0)

Notes on the sheet:
PN532
ENTRADA DE ALIMENTACIÓN
Comunicación serial
INTERFACES DISCRETAS
ESP 32 - controlador principal
ESP32 CAM

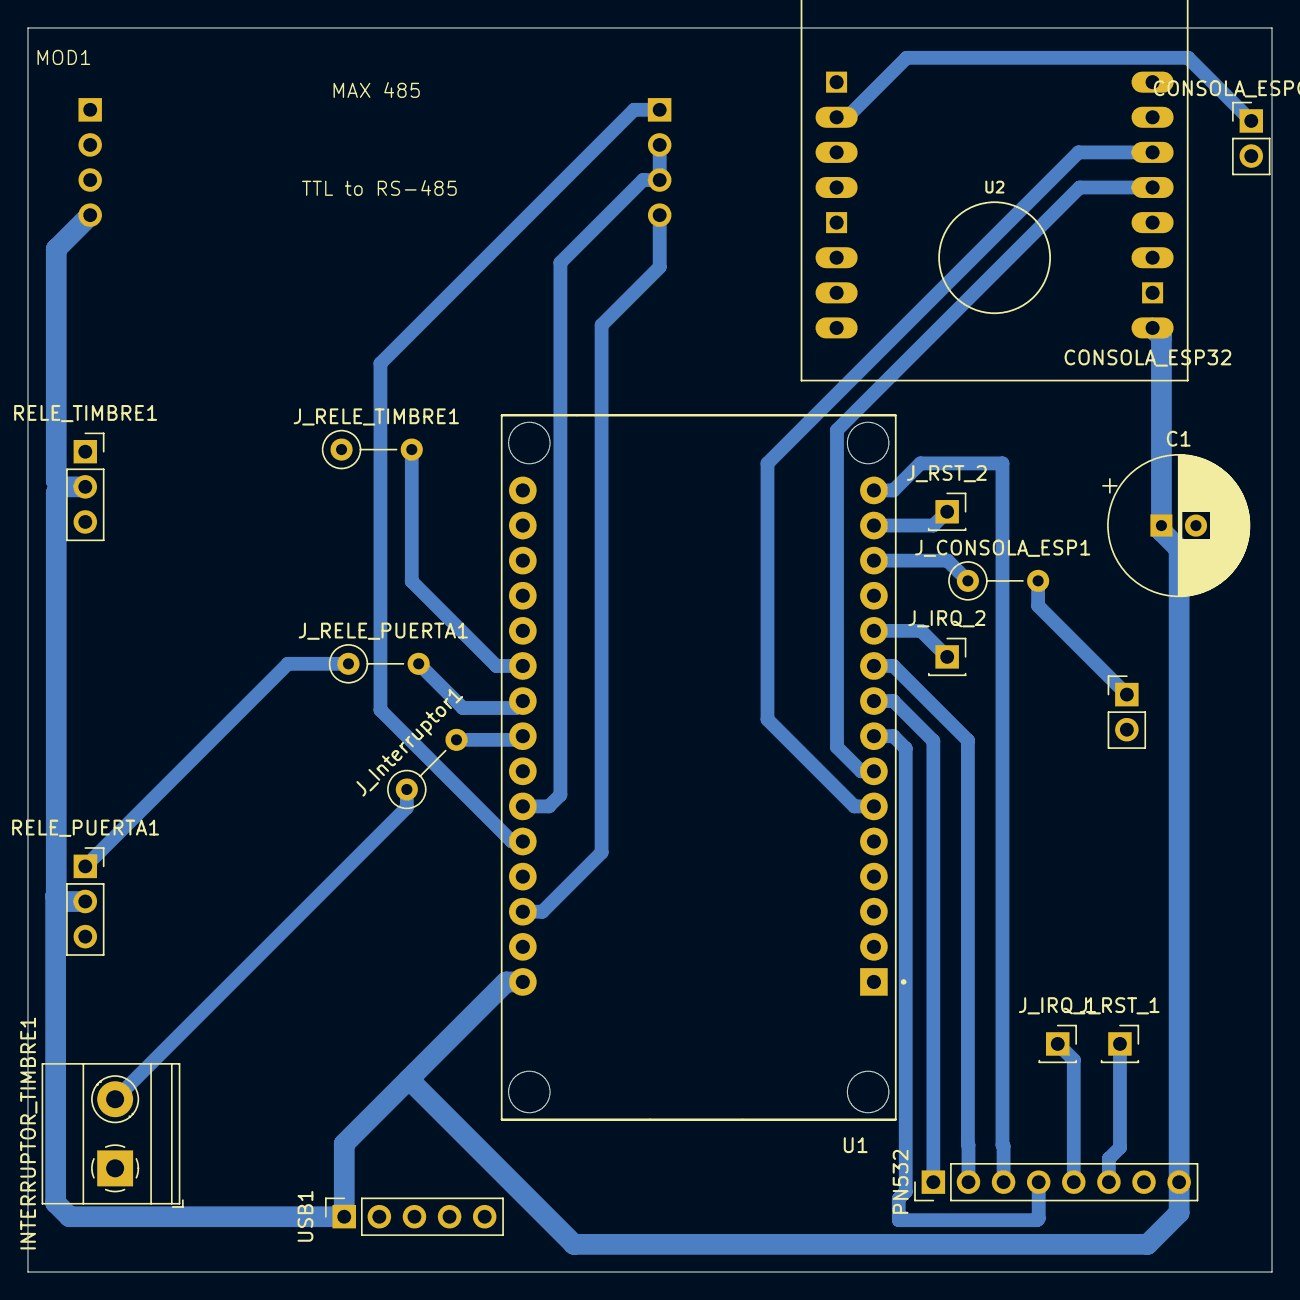
[picture p11: board PCB.kicad_pcb from above]

Board: 2 copper layers, 90.0 x 90.0 mm, 19 parts (0 on the bottom side), 24 nets.
