Jose-Ramonda/PROYECTOFINAL_MASTER/(commit log)

2026-06-28 Creacion de carpeta de PCB Y creación de proyecto
    [PCB.kicad_pcb, PCB.kicad_sch]
2026-06-29 PCB primera versión de prueba
    [ESQUEMA_OG.kicad_sch, PCB.kicad_pcb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]
2026-06-29 Inicio de sección 5 -> firmware
2026-07-04 Actualizacion 4_6 primer borrador de pirimera mitad
2026-07-13 Bot de telegram
2026-08-04 Version semidefinitiva - SASE
    [accesos_autorizados.csv, log_accesos.csv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]
2026-08-12 Version SASE
    [accesos_autorizados.csv, log_accesos.csv]
2026-08-17 Version de prueba para gittear de la RPI
    [PCB.kicad_pcb, PCB.kicad_sch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]
2026-08-17 cambio de token para repo publico
2026-08-17 Eliminacion de directorios obsoletos
2026-08-20 Actualizacion informe 19/8 - PCB
    [PCB.kicad_pcb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]
